geiyummei/Oscilloscope-500kHz/Oscilloscope/Oscilloscope.kicad_sch

## KiCad design Oscilloscope/Oscilloscope.kicad_sch (2026-07-27)

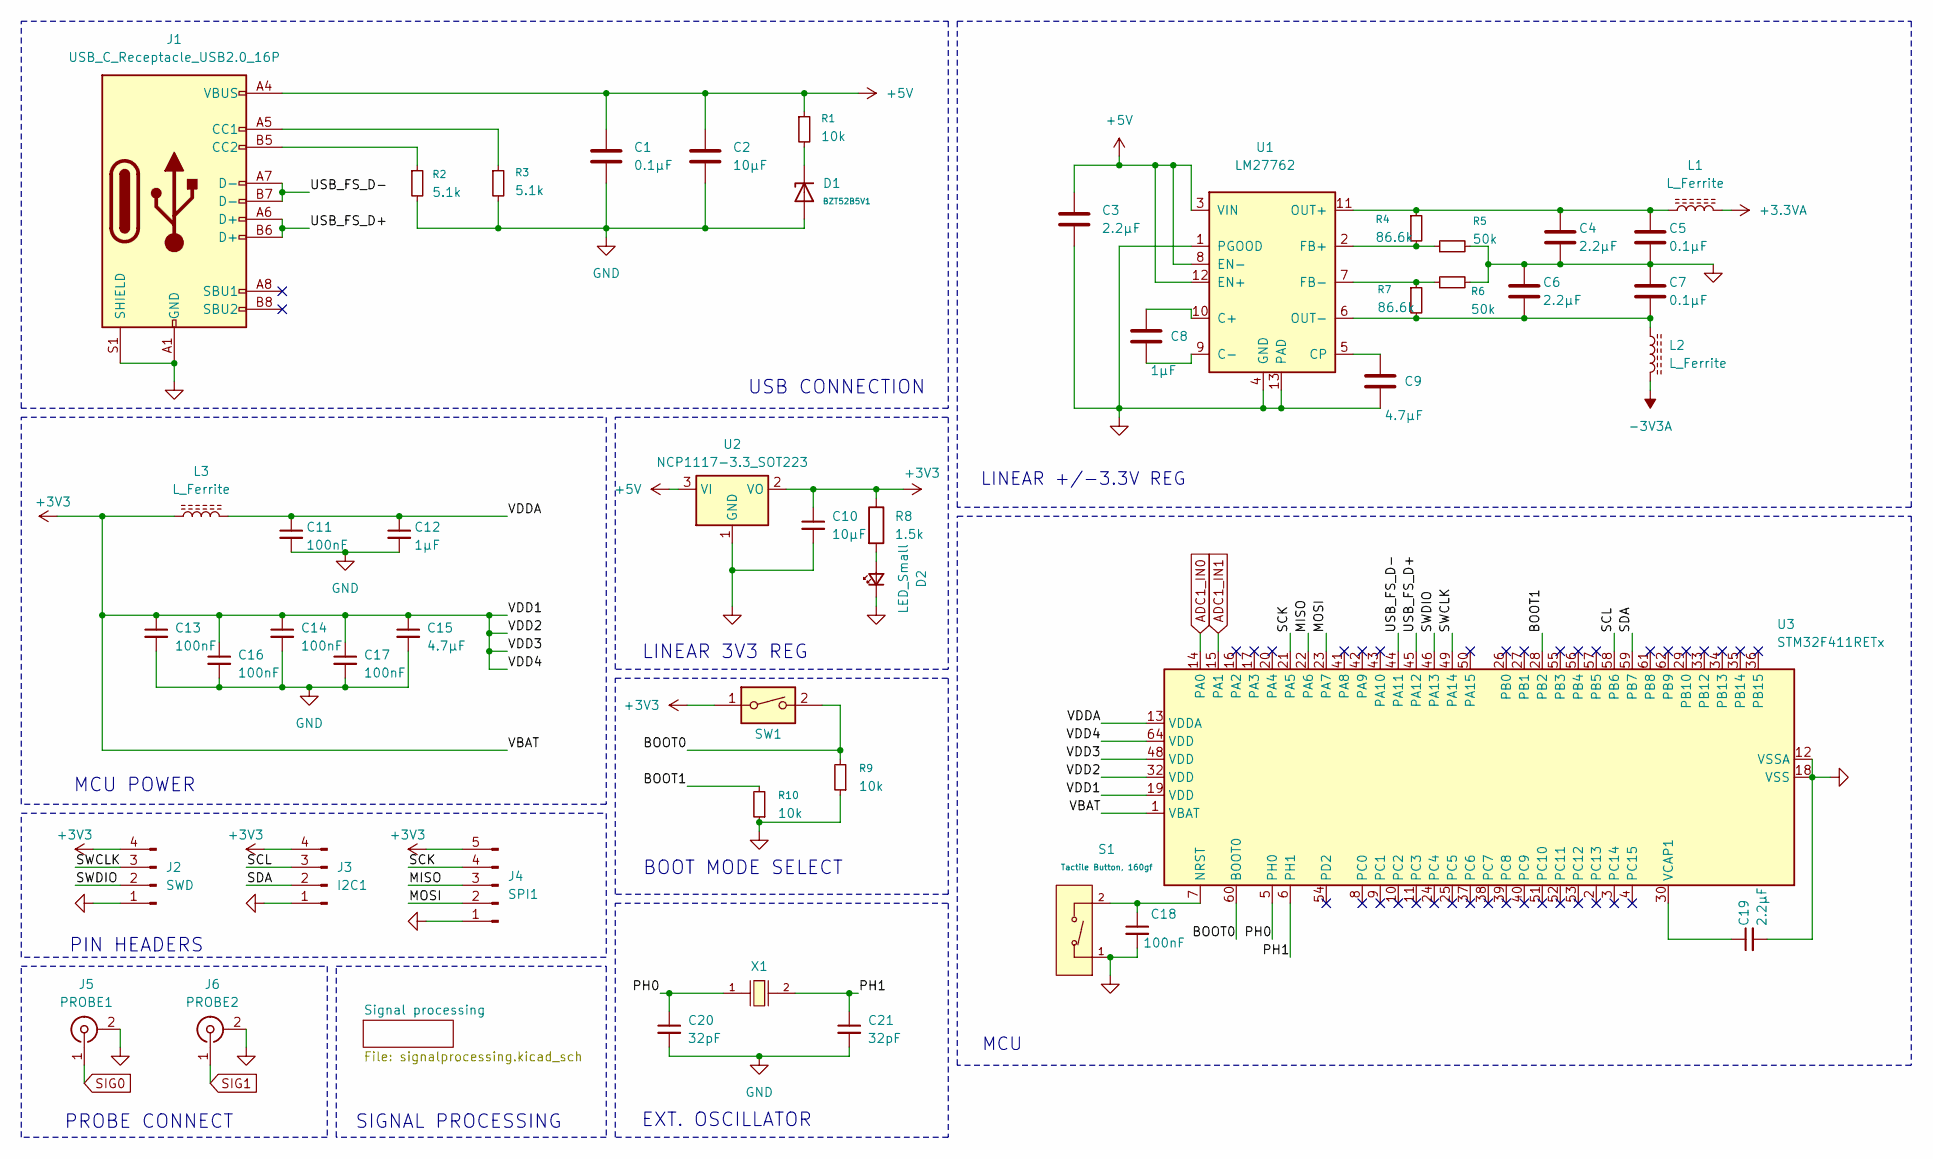
[picture p1: schematic Oscilloscope.kicad_sch]

Parts:
C1: 0.1µF; C_0201_0603Metric_Pad0.64x0.40mm_HandSolder
C2, C10: 10µF; C_0402_1005Metric
C3, C4, C6, C19: 2.2µF; C_0201_0603Metric
C5, C7: 0.1µF; C_0201_0603Metric
C8, C12: 1µF; C_0201_0603Metric
C9, C15: 4.7µF; C_0201_0603Metric
C11, C13, C14, C16, C17, C18: 100nF; C_0201_0603Metric
C20, C21: 32pF; C_0603_1608Metric
D1: BZT52B5V1; D_SOD-123; Part BZT52B5V1; LCSC C19077393
D2: LED_Small; LED_0201_0603Metric
J1: USB_C_Receptacle_USB2.0_16P; USB_C_Receptacle_GCT_USB4105-xx-A_16P_TopMnt_Horizontal
J2: SWD; PinHeader_1x04_P2.54mm_Vertical
J3: I2C1; PinHeader_1x04_P2.54mm_Vertical
J4: SPI1; PinHeader_1x05_P2.54mm_Vertical
J5: PROBE1; BNC_TEConnectivity_1478204_Vertical; LCSC C5137195
J6: PROBE2; BNC_TEConnectivity_1478204_Vertical; LCSC C5137195
L1, L2, L3: L_Ferrite; L_0201_0603Metric_Pad0.64x0.40mm_HandSolder
R1, R9, R10: 10k; R_0201_0603Metric
R2, R3: 5.1k; R_0201_0603Metric
R4, R7: 86.6k; R_0603_1608Metric
R5, R6: 50k; C_0402_1005Metric
R8: 1.5k; R_0201_0603Metric
S1: Tactile Button, 160gf; SW_TS-1088-AR02016; Voltage Rating (Dc) 12V; Part TS-1088-AR02016; LCSC C720477
SW1: SW_DIP_x01; PinHeader_1x02_P2.54mm_Vertical
U1: LM27762; WSON-12-1EP_3x2mm_P0.5mm_EP1x2.65_ThermalVias
U2: NCP1117-3.3_SOT223; SOT-223-3_TabPin2
U3: STM32F411RETx; LQFP-64_10x10mm_P0.5mm
X1: X50328MSB2GI; CRYSTAL-SMD_L5.0-W3.2; Frequency Tolerance ±10ppm; Part X50328MSB2GI; LCSC C115962

Connections:
+3.3VA: L1.2
+3V3: C10.1, C13.1, C14.1, C15.1, C16.1, C17.1, J2.4, J3.4, J4.5, L3.1, R8.1, SW1.1, U2.2 (VO), U3.1 (VBAT), U3.19 (VDD), U3.32 (VDD), U3.48 (VDD), U3.64 (VDD)
+5V: C1.1, C2.1, C3.1, J1.A4 (VBUS), J1.A9 (VBUS), J1.B4 (VBUS), J1.B9 (VBUS), R1.1, U1.3 (VIN), U1.8 (EN-), U1.12 (EN+), U2.3 (VI)
-3V3A: L2.2
ADC1_IN0: U3.14 (PA0)
ADC1_IN1: U3.15 (PA1)
BOOT0: R9.2, SW1.2, U3.60 (BOOT0)
BOOT1: R10.2, U3.28 (PB2)
GND: C1.2, C2.2, C3.2, C4.2, C5.2, C6.1, C7.1, C9.2, C10.2, C11.2, C12.2, C13.2, C14.2, C15.2, C16.2, C17.2, C18.2, C19.2, C20.2, C21.2, D1.2, D2.1 (K), J1.A1 (GND), J1.A12 (GND), J1.B1 (GND), J1.B12 (GND), J1.S1 (SHIELD), J2.1, J3.1, J4.1, J5.2 (Ext), J6.2 (Ext), R2.2, R3.2, R5.2, R6.2, R9.1, R10.1, S1.1 (A), U1.1 (PGOOD), U1.4 (GND), U1.13 (PAD), U2.1 (GND), U3.12 (VSSA), U3.18 (VSS), U3.31 (VSS), U3.47 (VSS), U3.63 (VSS)
MISO: J4.3, U3.22 (PA6)
MOSI: J4.2, U3.23 (PA7)
unnamed: C4.1, C5.1, L1.1, R4.1, U1.11 (OUT+)
unnamed: C6.2, C7.2, L2.1, R7.2, U1.6 (OUT-)
unnamed: C8.1, U1.10 (C+)
unnamed: C8.2, U1.9 (C-)
unnamed: C9.1, U1.5 (CP)
unnamed: C18.1, S1.2 (B), U3.7 (NRST)
unnamed: C19.1, U3.30 (VCAP1)
unnamed: D1.1, R1.2
unnamed: D2.2 (A), R8.2
unnamed: J1.A5 (CC1), R3.1
unnamed: J1.B5 (CC2), R2.1
unnamed: R4.2, R5.1, U1.2 (FB+)
unnamed: R6.1, R7.1, U1.7 (FB-)
PH0: C20.1, U3.5 (PH0), X1.1
PH1: C21.1, U3.6 (PH1), X1.2
SCK: J4.4, U3.21 (PA5)
SCL: J3.3, U3.58 (PB6)
SDA: J3.2, U3.59 (PB7)
SIG0: J5.1 (In)
SIG1: J6.1 (In)
SWCLK: J2.3, U3.49 (PA14)
SWDIO: J2.2, U3.46 (PA13)
USB_FS_D+: J1.A6 (D+), J1.B6 (D+), U3.45 (PA12)
USB_FS_D-: J1.A7 (D-), J1.B7 (D-), U3.44 (PA11)
VDDA: C11.1, C12.1, L3.2, U3.13 (VDDA)

Notes on the sheet:
USB CONNECTION
PIN HEADERS
MCU POWER
BOOT MODE SELECT
SIGNAL PROCESSING
LINEAR +/-3.3V REG
MCU
LINEAR 3V3 REG
PROBE CONNECT
EXT. OSCILLATOR
