geiyummei/Oscilloscope-500kHz/Oscilloscope/signalprocessing.kicad_sch

## KiCad design Oscilloscope/signalprocessing.kicad_sch (2026-07-27)

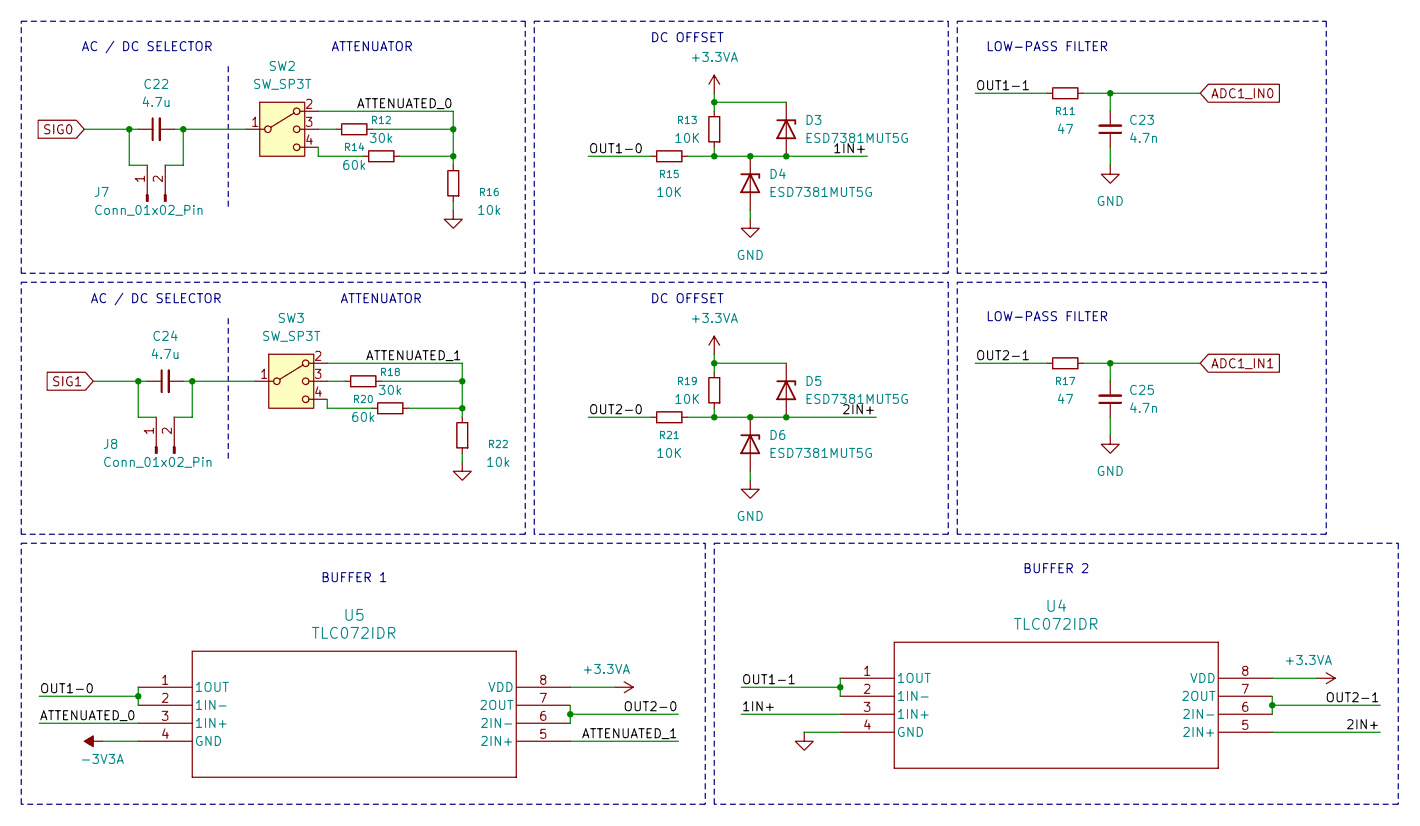
[picture p2: schematic signalprocessing.kicad_sch]

Parts:
C22, C24: 4.7u; C_0201_0603Metric
C23, C25: 4.7n; C_0201_0603Metric
D3, D4, D5, D6: ESD7381MUT5G; D_0201_0603Metric
J7, J8: Conn_01x02_Pin; PinHeader_1x02_P2.54mm_Vertical
R11, R17: 47; R_0201_0603Metric
R12, R18: 30k; R_0201_0603Metric
R13, R15, R19, R21: 10K; R_0201_0603Metric
R14, R20: 60k; C_0603_1608Metric
R16, R22: 10k; R_0201_0603Metric
SW2, SW3: SW_SP3T; Untitled
U4, U5: TLC072IDR; D8

Connections:
1IN+: D3.2 (A), D4.1 (K), R13.1, R15.2, U4.3 (1IN+)
2IN+: D5.2 (A), D6.1 (K), R19.1, R21.2, U4.5 (2IN+)
+3.3VA: D3.1 (K), D5.1 (K), R13.2, R19.2, U4.8 (VDD), U5.8 (VDD)
-3V3A: U5.4 (GND)
ADC1_IN0: C23.2, R11.2
ADC1_IN1: C25.2, R17.2
ATTENUATED_0: R12.2, R14.2, R16.2, SW2.2, U5.3 (1IN+)
ATTENUATED_1: R18.2, R20.2, R22.2, SW3.2, U5.5 (2IN+)
GND: C23.1, C25.1, D4.2 (A), D6.2 (A), R16.1, R22.1, U4.4 (GND)
unnamed: C22.2, J7.2, SW2.1
unnamed: C24.2, J8.2, SW3.1
unnamed: R12.1, SW2.3
unnamed: R14.1, SW2.4
unnamed: R18.1, SW3.3
unnamed: R20.1, SW3.4
OUT1-0: R15.1, U5.1 (1OUT), U5.2 (1IN-)
OUT1-1: R11.1, U4.1 (1OUT), U4.2 (1IN-)
OUT2-0: R21.1, U5.6 (2IN-), U5.7 (2OUT)
OUT2-1: R17.1, U4.6 (2IN-), U4.7 (2OUT)
SIG0: C22.1, J7.1
SIG1: C24.1, J8.1

Notes on the sheet:
AC / DC SELECTOR
BUFFER 2
ATTENUATOR
LOW-PASS FILTER
BUFFER 1
DC OFFSET
